JiaLiu-S/STM32F103C8T6/THIRD_PARTY_NOTICES.md

# Third-Party Notices

The root MIT license applies only to original VillaSecurity code and documentation unless a file header or this notice states otherwise. Third-party files retain their original copyright and license terms.

## Arm Limited

`RTE/Device/STM32F103C8/RTE_Device.h` contains an SPDX identifier for Apache License 2.0 and an Arm Limited copyright notice.

- License: Apache License 2.0
- License text: `third_party/licenses/Apache-2.0.txt`

## STMicroelectronics

The following files originate from the STM32F1 device support package and retain their STMicroelectronics copyright notices:

- `RTE/Device/STM32F103C8/startup_stm32f10x_md.s`
- `RTE/Device/STM32F103C8/system_stm32f10x.c`
- `RTE/Device/STM32F103C8/STM32F101_102_103_105_107.dbgconf`

The applicable ST software license text distributed with the installed STM32F1 package is included at `third_party/licenses/ST-SLA0044.txt`. These files are not relicensed under MIT and must be used in accordance with their original terms, including the restriction to STMicroelectronics microcontrollers or microprocessors.

## Generated Configuration

`RTE/_Target_1/RTE_Components.h` is generated project configuration metadata. It is included only to make the Keil project reproducible.
