JiaLiu-S/STM32F103C8T6/使用说明.md

# STM32 简易别墅安防系统

适用：STM32F103C8T6 最小系统板、Keil uVision5、四针 I2C OLED（默认 SSD1306，地址 0x3C）。这是一个桌面模型：红外模块只能检测其前方近距离物体，不能覆盖真实别墅，也不能代替正式安防设备。

## 功能

- 上电默认撤防；按一下按键布防，再按一下撤防。
- 布防时，反射式红外模块检测到靠近目标就报警；目标离开、红外恢复后自动停止报警。
- 热敏模块的 DO 达到设定阈值时，布防状态下报警；撤防时仅在屏幕显示状态，不鸣叫。温度恢复后自动清除提示。
- 报警时有源蜂鸣器间歇鸣叫，板载 PC13 LED 同步闪烁；布防且无报警时 LED 常亮。
- 外置绿灯在布防且无报警时常亮，外置红灯在报警时闪烁；撤防时两灯熄灭。
- OLED 显示布防、红外、温度和报警状态。屏幕用英文短词，源代码使用中文注释。
- OLED 每秒刷新一次；I2C 失联时会尝试重新初始化。
- USART1 从 PA9 向电脑发送状态；`PCMonitor/VillaSecurityMonitor.exe` 可显示实时报警、通知和事件记录。
- 上电时蜂鸣器和板载 LED 短暂自检；布防按键有短促确认音，撤防后保持静音。

## 接线

所有模块的 GND 必须与 STM32 共地。传感器和 OLED 的 VCC 均接 **3.3V**，不要把 5V 输出直接送入单片机 IO。

| 器件 | 器件端 | STM32 端 | 说明 |
| --- | --- | --- | --- |
| OLED | VCC, GND | 3.3V, GND | 四针未焊接版需先焊好排针 |
| OLED | SCL, SDA | PB6, PB7 | I2C；地址默认 0x3C |
| 反射式红外模块 | VCC, GND, DO | 3.3V, GND, PA0 | AO 不接；调电位器使靠近物体时 DO 触发 |
| 热敏电阻模块 | VCC, GND, DO | 3.3V, GND, PA1 | AO 不接；调电位器设报警阈值 |
| 清单中的独立立式按键 | 按下后才导通的两脚 | PA2、GND | 使用内部上拉；板载 RESET/RST 键只负责复位，不能代替此按键 |
| MH-FMD 低电平触发蜂鸣器模块 | VCC, GND, I/O | 已验证的 5V 电源、共地、PB10 | 正面朝上、针脚朝下时：左 VCC、中 I/O、右 GND；PB10 已配置为开漏输出 |
| 绿色 LED + 1kΩ 电阻 | PA3 → 1kΩ → LED 长脚，LED 短脚 → GND | PA3、GND | 每颗 LED 独立串联一只电阻；布防正常时常亮 |
| 红色 LED + 1kΩ 电阻 | PA4 → 1kΩ → LED 长脚，LED 短脚 → GND | PA4、GND | 报警时随蜂鸣器闪烁 |
| 板载 LED | PC13 | 无需接线 | 常见 Blue Pill 板自带，低电平点亮 |
| CH340 USB 转 TTL | RXD、GND | PA9、GND | 电脑监控用；TXD 和 VCC 不接 STM32，详见 `PCMonitor/使用说明.md` |

下载器 SWDIO 接 PA13，SWCLK 接 PA14，GND 接 GND；供电使用稳定的 3.3V。先确认下载器的引脚标识与供电方式，不要同时把多个 5V 电源直接并在一起。面包板电源模块如设为 5V，不能直接给上述信号模块的 VCC 供电。

## 打开与烧录

1. 双击 `VillaSecurity_STLink.uvprojx`，在 Keil 里打开预设 ST-LINK 的工程。
2. 按 F7 编译；生成的烧录文件位于 `Objects/VillaSecurity.hex`。
3. 工程默认按 ST-LINK 设置：将 ST-LINK 的 SWDIO、SWCLK、GND 与开发板接好并插入电脑，再执行 Download。若下载器外壳标注不是 ST-LINK，则在 `Options for Target > Debug` 及 `Utilities` 中改选实际型号。
4. 如果换电脑，需要安装 `Keil.STM32F1xx_DFP 2.4.1` 和 `ARM.CMSIS 4.3.0`，并检查工程的 CMSIS 头文件路径。当前工程已按本机 Keil 安装位置配置。

## 上电检查

1. 重新编译并 Download 后，按一下开发板复位键。板载 LED、红绿两灯应亮约 0.18 秒，蜂鸣器应短鸣；OLED 应显示 `MODE: DISARMED`。
2. 按 PA2 对 GND 的按键，应听到一次短鸣；OLED 变为 `MODE: ARMED`，绿灯和板载 LED 常亮。若 OLED 不亮，仍可先凭按键短鸣和 LED 判断主程序是否运行。
3. 用物体靠近反射式红外探头，屏幕的 ENTRY 应变为 DETECTED；布防状态下变为 ALARM，红灯与蜂鸣器同步动作。目标离开后应恢复为 CLEAR，红灯熄灭、绿灯重新常亮。
4. 按外置按键撤防后，红外不会触发蜂鸣器；再次布防即可恢复报警功能。
5. 调热敏模块电位器模拟阈值触发：布防时显示 `TEMP: ALARM` 并鸣叫；撤防后显示 `TEMP: HOT`，蜂鸣器停止。
6. 如果传感器状态与实际相反，在 `App/config.h` 中修改 `IR_ACTIVE_LOW` 或 `TEMP_ACTIVE_LOW`（1 改为 0）。如果 OLED 不亮，检查焊点、SCL/SDA、电源和 `OLED_I2C_ADDRESS`；少量 OLED 使用 0x3D 地址或 SH1106 控制器，SH1106 可尝试将 `OLED_COLUMN_OFFSET` 改为 2。

热敏模块的 DO 只提供阈值信号，本工程不会显示摄氏温度。系统也没有备用电源或联网通知，断电时无法报警。

## 出现 `No J-Link found` 时

这表示 Keil 正在寻找 J-Link 下载器，与 C 源码编译无关。请关闭当前 Keil 工程窗口，再双击此文件夹内的 `VillaSecurity_STLink.uvprojx`，让 ST-LINK 工程配置生效。确认下载器确实是 ST-LINK，并检查 USB 连接、设备管理器识别情况和 SWD 接线。如果它标注为 J-Link，需要连接真正的 J-Link 并在 Keil 中选择 J-Link；如果它是 CH340/USB 转 TTL，则不能使用 SWD 调试器，需改用串口 Bootloader 下载流程。

## 已烧录但没有反应时

先按 F7 编译最新代码，再按 Download，看到 `Programming Done` 和 `Verify OK` 后按开发板复位键。当前版本上电时 LED 与蜂鸣器会同时动作约 0.18 秒。若热敏触发时板载 LED 能闪，说明程序已经运行；蜂鸣器仍不响时重点核对其 VCC、GND、输入脚与 PB10。

按键连接到 PA2 和 GND，按下时必须真正让 PA2 与 GND 导通。可以先暂时拆下按键，用一根杜邦线将 PA2 短接 GND 再松开：若板载 LED 变为常亮，说明程序已经布防，问题在四脚按键的脚位或接线；再短接一次应撤防。四脚按键有两只脚常年互通，接在这两只脚上会让程序无法识别按下动作。

最小系统板上常见的 `RESET`/`RST` 按键会重启程序，并使系统重新进入撤防状态。它没有接到 PA2，按它不会切换布防状态。请使用物品清单中的独立按键开关，或者先用 PA2 短接 GND 的方式验证。

用物体靠近红外模块时，即使没有按布防键，屏幕也应显示 `ENTRY: DETECTED`，但撤防时不会因红外而鸣叫。若模块自身指示灯改变，但屏幕不变，检查模块的 **DO** 是否接 PA0（不是 AO）、VCC 是否为 3.3V、GND 是否共地，并尝试调节模块电位器。若实测靠近时 DO 为高电平，把 `App/config.h` 中 `IR_ACTIVE_LOW` 改为 0，重新编译烧录。

若屏幕能显示 `ENTRY: DETECTED` 但蜂鸣器不响，说明输入已读到，问题只在蜂鸣器链路。照片中的 MH-FMD 是三脚模块，蜂鸣器本体标为 TMB12A05（标称 5V）。你已验证模块用 5V 供电可以发声；5V 与 STM32 需共地，I/O 改接 PB10，不能继续接旧工程使用的 PB0。PB10 在 STM32F103C8 数据手册中标为 5V 容忍脚，程序以开漏方式拉低或释放；更改接线后要重新烧录本工程。

OLED 四针版若未焊接排针，要先焊牢；仅把杜邦线贴在孔上无法保证接触。检查 OLED VCC=3.3V、GND、SCL=PB6、SDA=PB7。程序与按键正常而屏幕仍全黑时，再确认屏幕控制器与 I2C 地址是否符合本工程默认的 SSD1306/0x3C。

若屏幕按 `RESET/RST` 时闪一下又黑屏，先关闭电源，重新压紧或焊好 OLED 的四根线，再通电测试。`RESET/RST` 只会重启 STM32，不会布防。最新程序会每秒重绘并在 I2C 无应答时重试；如果仍持续黑屏，要检查 OLED 3.3V 供电和 GND 是否稳定，尤其是未焊接的四针排针。反复按复位键不能修复接触不良。

## 源码分工

- `App/main.c`：布防状态、红外实时报警决策。
- `App/sensors.c`：传感器和按键消抖。
- `App/alarm.c`：蜂鸣器与 LED 的报警节奏。
- `Bsp/board.c`：GPIO 和毫秒时基。
- `Bsp/oled.c`：软件 I2C、SSD1306 显示驱动。
- `Bsp/serial_tx.c`：USART1 状态上报，115200 波特率。
- `PCMonitor/`：Windows 串口报警监控程序及源码。
- `App/config.h`：传感器触发电平和 OLED 地址参数。
