JiaLiu-S/STM32F103C8T6/接线诊断说明.md

# 接线诊断工程

先打开 `VillaSecurity_Diagnostics.uvprojx`，按 F7 编译，再点击 Download 烧录。诊断工程会暂时替换芯片内的安防程序；诊断结束后重新打开 `VillaSecurity_STLink.uvprojx` 并 Download 即可恢复。

若 OLED 刚上电没有应答，当前诊断程序会每秒尝试重新初始化并刷新屏幕。修改源码后必须重新按 F7 和 Download，已烧入芯片的旧程序不会自动更新。

诊断程序不需要布防，OLED 直接显示三个 GPIO 的原始电平：

| OLED 项目 | 连接 | 正常测试结果 |
| --- | --- | --- |
| `IR PA0` | 红外模块 DO 接 PA0 | 物体靠近/远离时 0 和 1 应切换 |
| `TEMP PA1` | 热敏模块 DO 接 PA1 | 调模块电位器使其指示灯切换时，数字也应切换 |
| `KEY PA2` | 独立按键接 PA2 与 GND | 松开为 1，按下为 0 |

诊断程序每 2 秒让 PB10 拉低 0.5 秒，板载 LED 同步闪烁。照片中的 MH-FMD 是三脚模块：正面朝上、针脚朝下时，左 VCC、中 I/O、右 GND。你已验证它用 5V 供电可以发声；5V 电源与 STM32 需共地，I/O 接 PB10。PB10 是 5V 容忍脚，程序以开漏方式控制。**旧版 PB0 接线必须断电拔下，重新烧录本工程后才接 PB10。**

如果屏幕上 `IR PA0` 不随红外模块自身指示灯变化，问题在 DO 到 PA0 的连线、共地或引脚辨认；如果 `KEY PA2` 按下仍是 1，问题在独立按键与 PA2/GND 的连线。最小系统板上的 RESET/RST 键只会复位，不是 PA2 按键。

## 根据当前测试结果排查

你目前的现象是：`TEMP PA1` 可以变为 0，`IR PA0` 一直为 1，`KEY PA2` 按下仍为 1，蜂鸣器无声。这表示 STM32 和 OLED 正常，热敏线基本正确；红外、按键和蜂鸣器需要重新按模块丝印接线。

1. 红外模块只把 **DO/D0** 接 PA0，不能把 **AO/A0** 接 PA0。模块的 VCC 接 3.3V、GND 接开发板 GND。靠近目标时先用万用表测 DO 对 GND 是否在 0V/3.3V 间变化；如果 DO 变化而 OLED 不变，就是 DO 到 PA0 的线或 PA0 引脚找错。
2. 独立四脚按键要跨面包板中间凹槽安装。按键的一侧任意一脚接 PA2，另一侧任意一脚接 GND；同一侧的两脚本来就是常通的，不能把 PA2 和 GND 接在同一侧。按下时 `KEY PA2` 必须从 1 变 0。板载 `RESET/RST` 按键不属于这个输入。
3. 蜂鸣器模块的 I/O 接 PB10；原先接 PB0 的接法已停用。更改后的诊断工程须重新编译并烧录，才会从 PB10 输出控制信号。

开发板上必须找印有 `PA0`、`PA2`、`PB10` 的排针，不能把它们按 Arduino 的 `A0/A2` 或其他丝印想当然替代。

请记录这三个数字在操作前后的变化，以及蜂鸣器是否随板载 LED 发声。根据结果再确定是否需要调整正式工程中的传感器触发极性。
