JiaLiu-S/STM32F103C8T6/论文/基于STM32的简易别墅安防系统设计与实现.docx

# 基于 STM32F103C8T6 的简易别墅安防系统设计与实现

嵌入式课程设计论文 | 2026 年 11 月

# 摘 要

针对课程实验中入侵识别、温度阈值判断及远程状态感知的需求，设计并实现一套基于 STM32F103C8T6 的简易别墅安防演示系统。系统以反射式红外模块和热敏模块的数字输出为输入，通过 10 ms 周期采样和连续样本确认抑制抖动；以独立按键控制布防和撤防，并用布防状态与传感器状态构造报警逻辑。OLED 显示当前状态，有源蜂鸣器和板载 LED 提供本地提示，USART1 经 CH340 向 Windows 监控程序发送带版本号的 ASCII 状态帧。上位机自动列出 COM 口，解析状态、记录报警事件，并在超过 3 s 未收到有效帧时显示通信中断。论文给出硬件接口、状态模型、串口负载与时序估算以及分层验证方法。当前固件和上位机均已通过编译，协议解析测试和窗口启动测试通过；新增串口链路尚未完成实物联调，因此不将理论响应时间写成实测性能。本设计适用于教学模型，不能替代具备冗余供电和可靠性认证的住宅安防设备。

关键词：STM32F103C8T6；安防报警；传感器消抖；SSD1306；串口通信；Windows 上位机

# Abstract

This paper presents a small villa security demonstrator built around the STM32F103C8T6 microcontroller. A reflective infrared sensor and a thermistor module provide digital threshold signals. The firmware samples them every 10 ms, confirms state changes with consecutive samples, and combines the confirmed inputs with an arm/disarm state to make the alarm decision. An SSD1306 based OLED displays the system state, while an active buzzer and the onboard LED provide local feedback. USART1 transmits versioned ASCII status frames through a CH340 USB to serial adapter to a Windows monitoring application. The application enumerates COM ports, parses frames, logs alarm transitions, and marks the link unavailable after three seconds without a valid frame. Hardware mapping, state logic, theoretical timing and bandwidth estimates, and a staged verification matrix are presented. The firmware and desktop application compile successfully, and parser and window startup checks have passed. End to end serial operation with the physical adapter remains to be measured. This implementation is intended for education and is not a certified residential alarm system.

Keywords: STM32F103C8T6; security alarm; debounce; OLED; serial communication; desktop monitoring

# 1 绪论

## 1.1 研究背景与目标

低成本微控制器能够把离散传感器、现场声光提示和计算机监控组合成可观察的嵌入式系统。STM32F103C8T6 属于基于 Arm Cortex-M3 的中等容量器件，具备 GPIO、USART、定时器与调试接口，标称最高主频 72 MHz，片上 Flash 为 64 KB，SRAM 为 20 KB[1]。本课题不追求覆盖真实住宅，而是建立从检测、判定、提示到上位机记录的完整实验链路。

设计目标包括：传感器状态稳定可读；撤防时不触发报警；布防时两类事件均可触发并在输入恢复后停止；本地屏幕与电脑界面同步呈现状态；断线时电脑明确标识状态未知。红外模块只判断探头前方近距离目标，热敏模块的 DO 仅表示阈值比较结果，不能据此推算目标距离或摄氏温度。

表 1 系统需求与验收准则

编号 | 需求 | 可观察准则
R1 | 布防与撤防 | 外置按键每次有效按下切换一次，OLED 状态同步变化
R2 | 现场报警 | 布防且红外或热敏触发时蜂鸣器与 PC13 间歇动作
R3 | 撤防安全 | 撤防时传感器变化可显示，但报警输出保持关闭
R4 | 串口监控 | Windows 软件接收有效帧后显示状态并记录报警转换
R5 | 故障可见 | 超过 3 s 未收到有效帧时显示通信中断

# 2 系统总体方案

## 2.1 分层结构

系统分为感知层、控制层、现场交互层和电脑监控层。感知层将红外与热敏模块的 DO 输出送入 MCU；控制层按周期采样、消抖、计算报警状态；现场交互层由 OLED、蜂鸣器和 LED 组成；电脑监控层通过 USART1—CH340—USB 链路接收状态。选择单向发送降低接线复杂度，布防控制仍由本地按键完成。CH340 提供 USB 到串口的转换，Windows 串口驱动将其呈现为 COM 端口[4]。

表 2 主要器件与设计作用

器件 | 数量 | 作用 | 选用与边界
STM32F103C8T6 | 1 | 状态控制与串口发送 | 3.3 V 逻辑，片上资源满足本设计[1]
反射式红外模块 | 1 | 入侵近距触发 | 读取 DO，非距离测量
热敏模块 | 1 | 温度阈值触发 | 读取 DO，非摄氏温度测量
0.96 英寸 OLED | 1 | 现场状态显示 | 按 SSD1306、I²C 地址 0x3C 配置[3]
低电平触发有源蜂鸣器 | 1 | 现场声响 | 模块由 5 V 供电，信号由 PB10 控制
CH340 USB 转 TTL | 1 | 电脑串口链路 | 仅用 RXD 与 GND，MCU 单向发送[4]

## 2.2 引脚与供电约束

MCU、传感器和 OLED 采用共地连接。传感器与 OLED 使用 3.3 V；蜂鸣器模块按已验证的供电方式使用 5 V，并共地。PB10 配置为开漏输出，以拉低或释放的方式控制低电平触发模块。PA9 仅输出到 CH340 的 RXD，CH340 的 TXD 与 VCC 不接 MCU。STM32F103 的器件数据手册和参考手册分别用于核对电源范围、GPIO 复用与 USART 寄存器配置[1][2]。

表 3 接口分配与电气连接

MCU 引脚 | 外设端 | 方向 | 软件配置或注意事项
PA0 | 红外 DO | 输入 | 内部上拉；低电平触发可配置
PA1 | 热敏 DO | 输入 | 内部上拉；低电平触发可配置
PA2 | 外置按键—GND | 输入 | 内部上拉；RST 键不能替代
PB6 / PB7 | OLED SCL / SDA | 输出/双向 | 软件 I²C，目标地址 0x3C
PB10 | 蜂鸣器 I/O | 输出 | 开漏，低电平触发
PC13 | 板载 LED | 输出 | 低电平点亮
PA9 | CH340 RXD | 输出 | USART1 TX，115200 bit/s
PA3 / PA4 | 外置绿灯 / 红灯 | 输出 | 预留接口；每灯须串联限流电阻

外置 LED 的电阻按限流关系设计。若取 GPIO 高电平 3.3 V、绿灯正向压降约 2.0 V、目标电流 1.3 mA，计算值约为 1 kΩ；实际压降和亮度应按具体灯珠复核。此处是选值示例，绿灯接线尚未完成可靠性验证。

R_(LED) = (V_GPIO − V_F)/(I_LED) (1)

# 3 控制逻辑与嵌入式软件设计

## 3.1 模块划分和执行时序

程序按功能拆分为 Board、Sensors、Alarm、OLED、SerialTx 与 main。SysTick 提供毫秒时基；主循环每 10 ms 处理一次输入与报警；OLED 在状态改变时立即刷新，同时每秒定期重绘；串口在状态改变时立即发送，平时每 500 ms 发送一次心跳帧。按键采用消抖后的边沿触发，开机默认撤防[9]。

表 4 固件模块职责

模块 | 输入 | 输出 | 职责
Board | 寄存器和时钟 | GPIO、毫秒计数 | 初始化引脚、控制本地输出
Sensors | PA0、PA1、PA2 | 稳定传感器与按键事件 | 周期采样、连续样本确认
Alarm | 布防、报警、时刻 | 蜂鸣器、LED 电平 | 生成报警节奏和按键反馈
OLED | 布防、红外、热敏 | 屏幕内容 | 显示状态并在失联时尝试重初始化
SerialTx | 状态、运行毫秒 | ASCII 状态帧 | 配置 USART1 并发送单向数据
main | 各模块状态 | 调度与决策 | 执行报警条件与刷新调度

## 3.2 消抖与事件确认

红外和热敏 DO 在阈值附近可能短时跳变，按键也可能产生机械抖动。令原始输入为 xᵣ[k]，稳定状态为 xₛ[k]，只有连续 N 个样本相同才更新稳定状态；传感器 N=5，按键 N=3，采样周期 Tₛ=10 ms[9]。用连续一致性定义如下：

xₛ[k] = xᵣ[k]，当最近 N 个样本相同；否则 xₛ[k] = xₛ[k−1] (2)

在采样周期严格稳定且循环没有被长时间阻塞的前提下，输入变化到确认的时间依相位约为 (N−1)Tₛ 至 NTₛ。故传感器约 40～50 ms，按键约 20～30 ms。这是模型估算，不包含模块内部比较器延迟、OLED 传输或 Windows 调度。

(N−1)Tₛ ≤ T_(confirm) ≤ NTₛ (3)

## 3.3 报警状态机

设 M=1 表示布防，I=1 表示红外确认触发，H=1 表示热敏确认触发，A=1 表示需要报警。报警的唯一判定条件为式（4）。该条件使撤防优先级高于传感器输入：即使 I 或 H 为 1，只要 M=0，A 必为 0。传感器恢复时 A 会在下一次调度中清零。

A(t) = M(t) ∧ [I(t) ∨ H(t)] (4)

表 5 布防与传感器组合真值表

M | I | H | A | 界面含义
0 | 0 | 0 | 0 | 撤防，输入正常
0 | 0 | 1 | 0 | 撤防，热敏触发但不报警
0 | 1 | 0 | 0 | 撤防，红外触发但不报警
0 | 1 | 1 | 0 | 撤防，两路触发但不报警
1 | 0 | 0 | 0 | 布防，正常
1 | 0 | 1 | 1 | 布防，热敏报警
1 | 1 | 0 | 1 | 布防，红外报警
1 | 1 | 1 | 1 | 布防，双路报警

报警时蜂鸣器、板载 LED 与红灯按 500 ms 周期动作，其中前 200 ms 为有效电平，理论占空比为 40%。正常布防时板载 LED 常亮；蜂鸣器仅在布防按键生效后提供约 80 ms 的确认音。撤防后声光报警输出关闭[9]。

D_(alarm) = (T_on)/(T_period) = 200/500 = 40% (5)

# 4 串口通信与上位机设计

## 4.1 USART1 状态帧

USART1 采用 115200 bit/s、8 数据位、无校验、1 停止位。STM32F1 的 USART 支持数据寄存器、状态寄存器与分数波特率生成，程序根据 APB2 分频计算 BRR[2]。报文采用 ASCII 与 CRLF 结尾，便于通用串口工具直接查看：VS1,运行毫秒,布防,红外,热敏,报警。版本前缀用于过滤其他串口文本，布尔字段限制为 0 或 1。

表 6 状态帧字段定义

字段 | 示例 | 类型与范围 | 含义
版本 | VS1 | 固定文本 | 识别本协议
运行时间 | 123456 | uint32 毫秒 | 设备启动后的时间戳
布防 | 1 | 0 或 1 | 0 撤防，1 布防
红外 | 0 | 0 或 1 | 1 表示确认触发
热敏 | 0 | 0 或 1 | 1 表示达到模块阈值
报警 | 0 | 0 或 1 | 须等于 M∧(I∨H)
结束符 | CRLF | 2 字节 | 界定一行报文

按 uint32 最大 10 位十进制字符计算，最长报文为 24 字节。8N1 每字节占 10 个线路比特，115200 bit/s 下单帧串行发送的理论时间约 2.08 ms。若只考虑每 500 ms 一次的周期帧，平均负载约 480 bit/s，占标称波特率约 0.417%；状态变化增加的即时帧没有计入该平均值。

L_(max) = 4 + 10 + 4×(1+1) + 2 = 24 byte (6)

T_(tx,max) = (10×24)/115200 s ≈ 2.08 ms (7)

η = (10×24/0.5)/115200 ≈ 0.417% (8)

## 4.2 Windows 软件处理链

上位机使用 .NET Framework Windows Forms 与 System.IO.Ports.SerialPort。GetPortNames 枚举当前注册的 COM 口；该 API 返回的是系统串口名称，不保证一定是本设备，因此用户仍需选择实际的 CH340 端口[5]。DataReceived 在辅助线程触发，程序先读取数据，再通过 BeginInvoke 将状态更新投递到 UI 线程，符合微软对跨线程界面访问的要求[6]。

接收端以换行符重组报文，先检查前缀、字段个数、数值范围和报警逻辑一致性，再更新界面。状态从非报警转为报警时记录事件、播放系统提示音并调用 NotifyIcon 气泡通知[7]；报警恢复、布防切换和通信中断也写入事件表。日志可导出带 UTF-8 BOM 的 CSV，以便中文表头在常见表格软件中打开。

心跳间隔为 0.5 s，上位机每秒检查一次最后有效帧时间。若间隔大于 3 s，状态从“正常/报警”切换为“通信中断”，旧传感器数值不再作为当前值显示。该阈值相当于容忍约 6 个周期帧缺失；由于检查定时器为 1 s，界面告警通常发生在最后有效帧后略大于 3 s 至约 4 s 之间，具体取决于 UI 调度。

C(t) = 1，若 t − t_(last) > 3 s；否则 C(t) = 0 (9)

表 7 电脑端可见状态与动作

状态 | 判据 | 用户可见动作
等待连接 | 尚未打开 COM 口 | 提示选择并连接串口
等待数据 | 已打开串口但无有效帧 | 不显示安全结论
已撤防 | 有效帧 M=0 | 显示传感器值，报警为关闭
已布防正常 | 有效帧 M=1、A=0 | 显示正常状态
报警中 | 有效帧 A=1 | 醒目提示、声音、气泡、事件记录
通信中断 | 3 s 以上无有效帧 | 清除旧状态并记录故障

# 5 资源与时序分析

Keil ARM Compiler 6.24 对当前正式工程的构建输出为 Code=4288 B、RO-data=612 B、RW-data=4 B、ZI-data=1656 B，0 个错误和 0 个警告。按 STM32F103C8T6 的 64 KiB Flash、20 KiB SRAM 计算，静态占用约为式（10）。这些值来自一次构建，不等价于运行时峰值堆栈或全部动态内存；源代码改动后应重新统计[1][8][9]。

U_(Flash) = (4288+612)/65536 ≈ 7.48%；U_(SRAM) = (4+1656)/20480 ≈ 8.11% (10)

表 8 关键时间参数及性质

参数 | 取值 | 性质 | 说明
输入采样周期 | 10 ms | 程序设定 | 主循环周期；受阻塞操作影响
传感器确认 | 约 40～50 ms | 理论估算 | 5 次连续一致，未计外设延迟
按键确认 | 约 20～30 ms | 理论估算 | 3 次连续一致
报警闪烁周期 | 500 ms | 程序设定 | 高电平/拉低有效窗口 200 ms
串口心跳 | 500 ms | 程序设定 | 状态改变时另发即时帧
最长单帧发送 | 约 2.08 ms | 线路理论值 | 24 字节、115200 bit/s、8N1
断线判定 | >3 s | 程序设定 | 检查定时器间隔 1 s

# 6 验证方案与结果边界

## 6.1 分层验证记录

验证分为软件静态构建、协议解析、桌面窗口启动和实物联调。当前可核对的记录表明：正式固件已由 Keil 完整重建，输出 HEX；桌面 EXE 已编译并能创建可见窗口；协议解析测试覆盖正常布防、撤防、错误报警字段、噪声文本和 uint32 最大值。用户此前在硬件调试中观察到 OLED 显示、红外模块状态变化、热敏变化及蜂鸣器受控发声，但这些观察不包含新增串口固件与上位机的完整联调[9]。

表 9 测试矩阵与证据等级

测试项 | 方法/输入 | 当前结果 | 证据性质
Keil 完整重建 | 正式 ST-Link 工程 | 通过：0 错误、0 警告 | 构建日志
HEX 生成 | Objects/VillaSecurity.hex | 通过：文件已生成 | 构建产物
桌面程序编译 | C# 编译器 | 通过：EXE 已生成 | 构建产物
窗口启动 | 运行 EXE 并读取窗口标题 | 通过：窗口正常存在 | 本机软件检查
协议解析 | 5 组有效/无效报文 | 通过：5/5 | 软件单元检查
OLED/传感器/蜂鸣器 | 前期逐模块人工观察 | 曾观察到变化与发声 | 历史观察，非定量测量
CH340 实物链路 | PA9→RXD、GND 共地 | 待验证 | 尚无连接记录
端到端延迟/误报率 | 多轮触发与计时 | 待测量 | 不得用理论值替代

## 6.2 后续实物测试设计

完成串口接线与新版固件烧录后，应依次执行撤防触发、布防红外触发、布防热敏触发、双路同时触发、目标撤离、主动拔掉 CH340 和重新连接等试验。每项至少记录触发时刻、OLED 状态、蜂鸣器动作、电脑状态与事件日志；重复测试并统计成功次数及延迟分布，才能报告实际响应时间与误报率。若使用示波器，可比较 DO 边沿、PB10 电平与 PA9 首帧起始位，从而分离检测、执行和通信延迟。

表 10 建议的端到端实测记录表

场景 | 预期报警 | 本地输出 | 电脑输出 | 待记录量
撤防+红外触发 | 否 | 蜂鸣器静音 | 显示红外触发 | 是否误报
布防+红外触发 | 是 | 间歇鸣叫 | 报警事件 | 触发至提示延迟
布防+热敏触发 | 是 | 间歇鸣叫 | 报警事件 | 阈值稳定性
报警后撤防 | 否 | 立即停止 | 报警解除事件 | 清除延迟
拔掉 CH340 | 状态未知 | MCU 独立运行 | 通信中断 | 断线提示延迟

# 7 局限性与改进方向

首先，反射式红外只覆盖探头前方局部空间，热敏 DO 为可调比较阈值，两者都不构成可靠的火灾或入侵判定依据。其次，布防状态在上电或复位后默认为撤防，系统没有断电保持与备用电源。再者，当前串口协议没有校验和、设备身份认证或加密，也没有双向确认机制；串口线或电脑失效时，现场蜂鸣器仍可工作，但电脑无法得到新事件。Windows 通知还受系统通知设置影响，不能保证每次气泡可见[7]。

改进应以可靠性为先：引入独立看门狗与掉电恢复策略；传感器使用标定数据或更适合的探测器；协议增加序号、CRC 与设备身份；记录使用 RTC 时间戳；在联调基础上测量误报率、漏报率与端到端延迟。若要用于真实住宅，还需符合适用场景的电气安全、备用电源、安装与报警行业要求。本设计的计算和演示结果不能替代此类验证。

表 11 主要风险及改进优先级

风险 | 后果 | 现有处理 | 建议改进
传感器误触发 | 误报或漏报 | 5 样本消抖 | 标定阈值、增加多源判定
断线或掉电 | 电脑失去监测 | 3 s 心跳超时 | 备用电源、硬件故障输出
无报文校验 | 错误帧可能误判 | 格式和逻辑一致性检查 | 序号与 CRC
上电默认撤防 | 复位后保护中断 | 本地显示状态 | 非易失配置与安全启动策略
单点短距红外 | 覆盖有限 | 课程模型定位 | 按场景部署合适探测器

# 8 结论

本文完成了一个从传感器输入到本地报警、OLED 展示和 Windows 串口监控的课程设计方案，并把布防约束、消抖条件、报文结构和通信失效显示规则明确化。工程构建与软件解析测试说明实现已具备继续联调的基础；串口实物链路、实际响应时间和长期稳定性仍需按测试矩阵采集证据。该设计的主要价值在于可分模块观察与验证，不应将其解释为可直接部署的住宅安防产品。

# 参考文献

[1] STMicroelectronics. STM32F103x8/STM32F103xB datasheet, DS5319 Rev 20[EB/OL]. (2025-07)[2026-11-04]. https://www.st.com/resource/en/datasheet/stm32f103c8.pdf

[2] STMicroelectronics. RM0008: STM32F101xx/102xx/103xx/105xx/107xx reference manual, Rev 21[EB/OL]. (2021-02)[2026-11-04]. https://www.st.com/resource/en/reference_manual/rm0008-stm32f103xx-advanced-armbased-32bit-mcus-stmicroelectronics.pdf

[3] Solomon Systech. SSD1306 product information[EB/OL]. [2026-11-04]. https://www.solomon-systech.com/product/ssd1306

[4] Nanjing Qinheng Microelectronics. CH340 USB to serial converter datasheet and driver information[EB/OL]. [2026-11-04]. https://www.wch.cn/downloads/CH340DS1_PDF.html

[5] Microsoft. SerialPort.GetPortNames Method[EB/OL]. [2026-11-04]. https://learn.microsoft.com/en-us/dotnet/api/system.io.ports.serialport.getportnames

[6] Microsoft. SerialPort.DataReceived Event[EB/OL]. [2026-11-04]. https://learn.microsoft.com/en-us/dotnet/api/system.io.ports.serialport.datareceived

[7] Microsoft. NotifyIcon Component Overview: Windows Forms[EB/OL]. [2026-11-04]. https://learn.microsoft.com/en-us/dotnet/desktop/winforms/controls/notifyicon-component-overview-windows-forms

[8] Arm Keil. µVision User's Guide: Build the Project[EB/OL]. [2026-11-04]. https://www.keil.com/support/man/docs/uv4cl/uv4cl_ca_buildproject.htm

[9] 本课题. VillaSecurity 固件、PCMonitor 上位机源码与构建日志[Z]. 本地工程文件，2026-11-04.
