JiaLiu-S/STM32F103C8T6/CHANGELOG.md

# Changelog

本项目遵循语义化版本格式记录公开版本。

## 1.0.0 - 2026-11-05

- 发布 STM32F103C8T6 正式安防固件。
- 发布独立接线诊断固件。
- 发布 SSD1306 OLED、蜂鸣器、状态 LED 和传感器驱动。
- 发布 USART1 `VS1` 状态协议及 Windows Forms 监控程序。
- 补充完整接线说明、诊断说明和课程设计论文。
- 补充开源许可证、第三方版权说明和贡献指南。
